scarleast/airQ-TVOC-sensor/文档/AirQ原理图.pdf

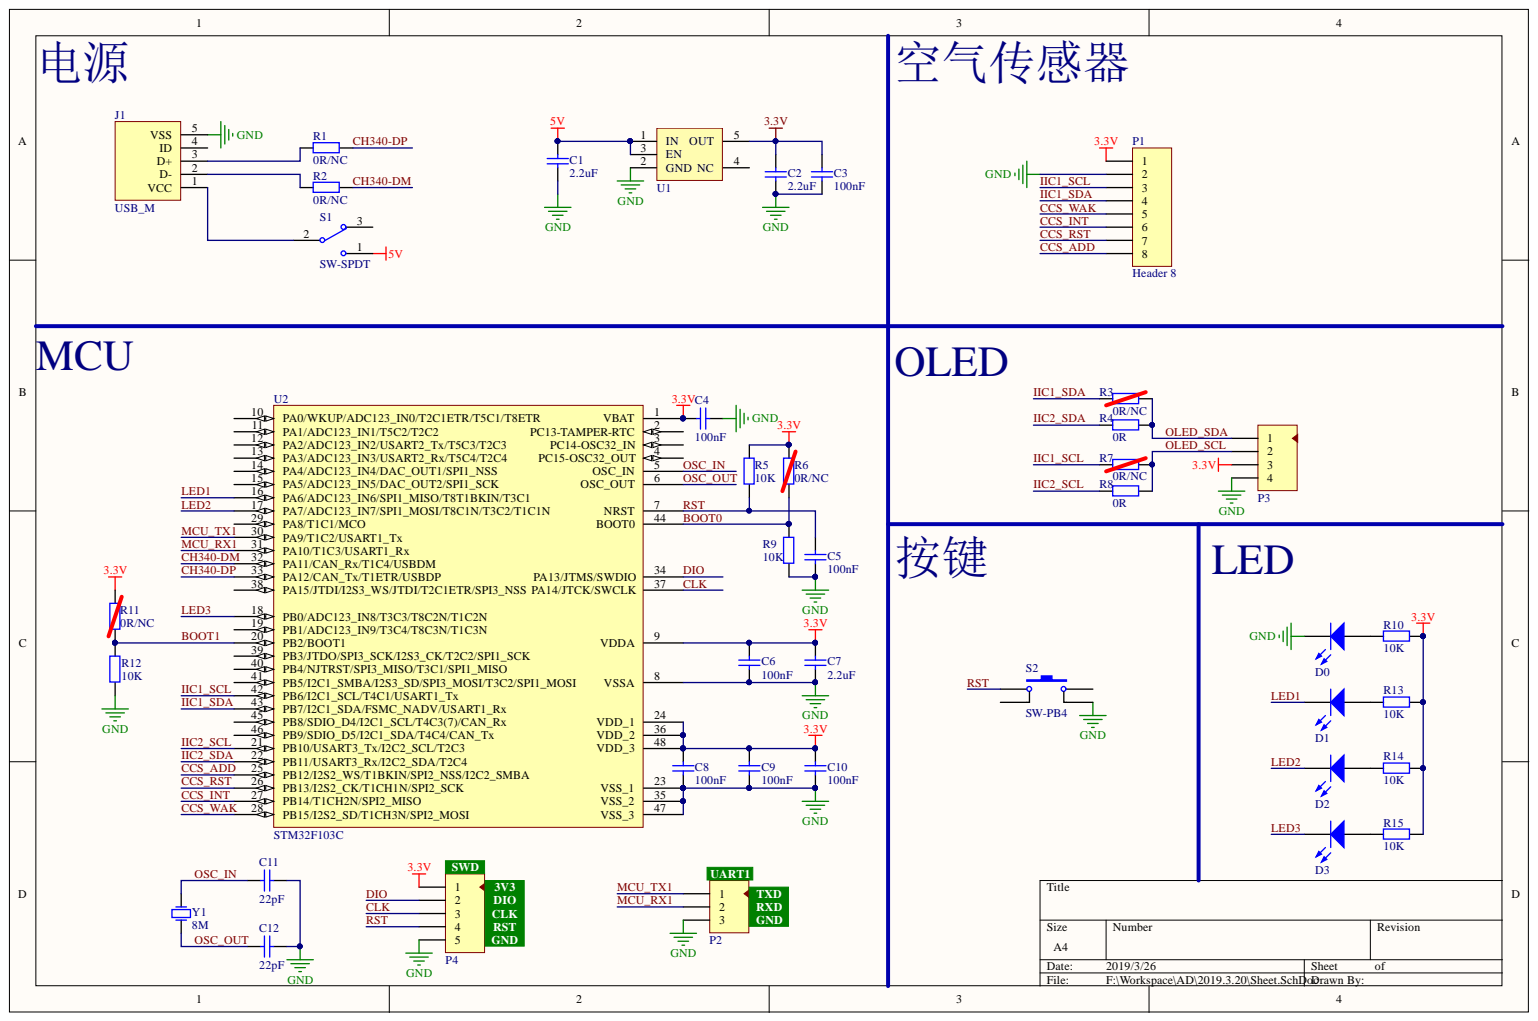
[picture p1: page 1]

Bill of Materials | Bill of Materials For Project [AirQ.PrjPCB] (No PCB Document Selected)
Source Data From: | AirQ.PrjPCB
Project: | | AirQ.PrjPCB
Variant: | | None
Creation Date: 2019/3/26 | 22:51:52
Print Date: | 26-Mar-19 | 10:52:01 PM
Footprint | Comment | LibRef | Designator | Description | Value | Quantity
C-0805 | Cap-S | Cap-S | C1, C2, C7 | 贴片瓷片电容 | 2.2uF | 3
C-0805 | Cap-S | Cap-S | C3, C4, C5, C6, C8, C9, C10 | 贴片瓷片电容 | 100nF | 7
C-0805 | Cap-S | Cap-S | C11, C12 | 贴片瓷片电容 | 22pF | 2
LED-0805 | LED0 | LED0 | D0, D1, D2, D3 | 发光二极管 | | 4

## USB-MICRO- A01SB141B1

-261 | USB_M | USB_M | J1 | Micro/Mini USB | | 1
HDR1X8 | Header 8 | Header 8 | P1 | Header, 8-Pin | | 1
HDR3X1-2.54 | Header 3 | Header 3 | P2 | 接插件 | | 1
HDR4X1-2.54 | Header 4 | Header 4 | P3 | 接插件 | | 1
HDR5X1-2.54 | Header 5 | Header 5 | P4 | 接插件 | | 1
0805-1 | Res1 | Res1 | R1, R2, R3, R6, R7, R11 | 贴片电阻 | 0R/NC | 6
0805-1 | Res1 | Res1 | R4, R8 | 贴片电阻 | 0R | 2
0805-1 | Res1 | Res1 | R5, R9, R10, R12, R13, R14, R15 | 贴片电阻 | 10K | 7
SWITCH_A2 | SW-SPDT | SW-SPDT | S1 | 开关 | | 1
SW_PB2_A1 _1 | SW-PB4 | SW-PB4 | S2 | 微动开关 | | 1
SOT23-5 | LDO-3.3V | LDO | U1 | 稳压芯片 | SPX3819 3.3V | 1
LQFP-48 | STM32F103C | STM32F103C | U2 | STM32单片机48引脚 | | 1
X-HC-49S | XTAL | XTAL | Y1 | 晶振 | 8M | 1
| | | | | | 41
Approved | | Notes
