scarleast/airQ-TVOC-sensor/(list of files, drawings)

Other design files:
硬件/AirQ.PcbDoc
硬件/AirQ.PrjPCB
硬件/AirQ.SchDoc
