scarleast/airQ-TVOC-sensor/stm32cube/Core/Src/main.c

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
/* Includes ------------------------------------------------------------------*/
#include "main.h"
#include "adc.h"
#include "i2c.h"
#include "rtc.h"
#include "usart.h"
#include "gpio.h"

/* USER CODE BEGIN Includes */
#include "oled.h"
#include "stdio.h"
#include "CCS811_Basic.h"
#include "hdc1080.h"
/* USER CODE END Includes */


void SystemClock_Config(void);
/**
  * @brief  The application entry point.
  * @retval int
  */
int main(void)
{
  /* MCU Configuration--------------------------------------------------------*/

  /* Reset of all peripherals, Initializes the Flash interface and the Systick. */
  HAL_Init();

  /* Configure the system clock */
  SystemClock_Config();

  /* Initialize all configured peripherals */
  MX_GPIO_Init();
  MX_RTC_Init();
  MX_ADC_Init();
  MX_USART1_UART_Init();
  MX_I2C2_Init();
  /* USER CODE BEGIN 2 */
	OLED_Init();
	OLED_Clear();

	OLED_ShowString(10, 0, "TVOC Sensor V2", 16);
	OLED_ShowString(40, 4, "Gaficat", 16);
	hdc1080_init();

	if(configureCCS811()){
////		  OLED_ShowString(0, 0, "ccs811 init success!", 16);
//		OLED_ShowNum(0, 4, 400, 3,16);
	}




	OLED_Clear();
//	OLED_ShowCHinese(0,2,1);
//	OLED_ShowCHinese(0,4,2);
//	OLED_ShowCHinese(0,6,3);
	OLED_ShowString(0, 0, "TVOC:", 16);
	OLED_ShowString(0, 2, "eCO2:", 16);
	OLED_ShowString(0, 4, "Temp:", 16);
	OLED_ShowString(0, 6, "humidity:", 16);

//  unsigned char data[] = "HAL UART CPU Transmit success!\t\n";
//  HAL_UART_Transmit(&huart1, data, sizeof(data), 0xffff);
//  unsigned char data1[] = "HAL UART DMA Transmit success!\t\n";
//  HAL_UART_Transmit_DMA(&huart1, data1, sizeof(data1));
//  printf("hello print! %f \n", 3.14);
//  printf("ccs init status:%d\n", configureCCS811());

//  OLED_Clear();
//  OLED_ShowChar(0, 0, 'A', 16);
//  OLED_ShowChar(0, 2, 'B', 16);
//  OLED_ShowChar(0, 4, 'C', 16);
//  OLED_ShowChar(0, 6, 'D', 16);
//
//  OLED_ShowChar(15, 0, 'A', 12);
//  OLED_ShowChar(15, 1, 'B', 12);
//  OLED_ShowChar(15, 2, 'C', 12);
//  OLED_ShowChar(15, 3, 'D', 12);
//  OLED_ShowChar(15, 4, 'E', 12);
//  OLED_ShowChar(15, 5, 'F', 12);
//  OLED_ShowChar(15, 6, 'G', 12);
//  OLED_ShowChar(15, 7, 'H', 12);
//
//  OLED_ShowString(30, 0, "mculover666", 12);
//
//  OLED_ShowCHinese(35, 2, 0);
//  OLED_ShowCHinese(65, 2, 1);
//  OLED_ShowCHinese(95, 2, 2);
//
//  OLED_ShowString(36, 6, "IoT Board", 16);



//  HAL_GPIO_WritePin(GPIOA, GPIO_PIN_0, GPIO_PIN_SET);
//  HAL_GPIO_WritePin(GPIOB, GPIO_PIN_2, GPIO_PIN_SET);
  /* USER CODE END 2 */

  /* Infinite loop */
  /* USER CODE BEGIN WHILE */

  while (1)
  {
//	  HAL_GPIO_TogglePin(GPIOB, GPIO_PIN_2);

	  HAL_Delay(1000);
    /* USER CODE END WHILE */

    /* USER CODE BEGIN 3 */
  }
  /* USER CODE END 3 */
}

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
 /**
  * @brief  Period elapsed callback in non blocking mode
  * @note   This function is called  when TIM1 interrupt took place, inside
  * HAL_TIM_IRQHandler(). It makes a direct call to HAL_IncTick() to increment
  * a global variable "uwTick" used as application time base.
  * @param  htim : TIM handle
  * @retval None
  */
void HAL_TIM_PeriodElapsedCallback(TIM_HandleTypeDef *htim)
{
  if (htim->Instance == TIM1) {
    HAL_IncTick();
  }
}

/**
  * @brief  This function is executed in case of error occurrence.
  * @retval None
  */
void Error_Handler(void)
{
  /* USER CODE BEGIN Error_Handler_Debug */
  /* User can add his own implementation to report the HAL error return state */
  __disable_irq();
  while (1)
  {
  }
  /* USER CODE END Error_Handler_Debug */
}

#ifdef  USE_FULL_ASSERT
/**
  * @brief  Reports the name of the source file and the source line number
  *         where the assert_param error has occurred.
  * @param  file: pointer to the source file name
  * @param  line: assert_param error line source number
  * @retval None
  */
void assert_failed(uint8_t *file, uint32_t line)
{
  /* USER CODE BEGIN 6 */
  /* User can add his own implementation to report the file name and line number,
     ex: printf("Wrong parameters value: file %s on line %d\r\n", file, line) */
  /* USER CODE END 6 */
}
#endif /* USE_FULL_ASSERT */

/************************ (C) COPYRIGHT STMicroelectronics *****END OF FILE****/
