scarleast/airQ-TVOC-sensor/stm32cube/Core/Inc/main.h

#define PWR_EN_Pin GPIO_PIN_0
#define PWR_EN_GPIO_Port GPIOA
#define POWER_EN_ADC_Pin GPIO_PIN_1
#define POWER_EN_ADC_GPIO_Port GPIOA
#define BAT_ADC_Pin GPIO_PIN_4
#define BAT_ADC_GPIO_Port GPIOA
#define Key1_Pin GPIO_PIN_7
#define Key1_GPIO_Port GPIOA
#define Key1_EXTI_IRQn EXTI4_15_IRQn
#define Key2_Pin GPIO_PIN_0
#define Key2_GPIO_Port GPIOB
#define Key2_EXTI_IRQn EXTI0_1_IRQn
#define Key3_Pin GPIO_PIN_1
#define Key3_GPIO_Port GPIOB
#define Key3_EXTI_IRQn EXTI0_1_IRQn
#define LED0_Pin GPIO_PIN_2
#define LED0_GPIO_Port GPIOB
#define CCS_WAKE_Pin GPIO_PIN_12
#define CCS_WAKE_GPIO_Port GPIOB
#define CCS_INT_Pin GPIO_PIN_13
#define CCS_INT_GPIO_Port GPIOB
#define CCS_INT_EXTI_IRQn EXTI4_15_IRQn
#define CCS_RST_Pin GPIO_PIN_14
#define CCS_RST_GPIO_Port GPIOB
#define CCS_ADD_Pin GPIO_PIN_15
#define CCS_ADD_GPIO_Port GPIOB
#define WB3S_KEY_Pin GPIO_PIN_8
#define WB3S_KEY_GPIO_Port GPIOA
#define WB3S_EN_Pin GPIO_PIN_11
#define WB3S_EN_GPIO_Port GPIOA
#define WB3S_CEN_Pin GPIO_PIN_12
#define WB3S_CEN_GPIO_Port GPIOA
