scarleast/airQ-TVOC-sensor/software_v1/Config/Port.c

#include "Port.h"
#include "stm32f10x.h"

/*
	配置LED的IO口
*/
static void Port_Config_LED(void)
{
	GPIO_InitTypeDef GPIO_InitStructure;
	
	RCC_APB2PeriphClockCmd(RCC_APB2Periph_GPIOA, ENABLE);   /* 开启PORTA外设时钟 */
	RCC_APB2PeriphClockCmd(RCC_APB2Periph_GPIOB, ENABLE);   /* 开启PORTB外设时钟 */
	
	RCC_APB2PeriphClockCmd(RCC_APB2Periph_AFIO, ENABLE);    /* 开启复用时钟 */
	GPIO_PinRemapConfig(GPIO_Remap_SWJ_JTAGDisable, ENABLE);/* 禁用PB4的JTAG复用 */
	
	GPIO_InitStructure.GPIO_Pin = GPIO_Pin_6 | GPIO_Pin_7;
	GPIO_InitStructure.GPIO_Mode = GPIO_Mode_Out_PP;
	GPIO_InitStructure.GPIO_Speed = GPIO_Speed_50MHz;
	
	GPIO_Init(GPIOA, &GPIO_InitStructure);
    
    GPIO_InitStructure.GPIO_Pin = GPIO_Pin_0;
    GPIO_Init(GPIOB, &GPIO_InitStructure);
}

/*
	CCS相关GPIO配置
*/
static void Port_Config_CCS(void)
{
	GPIO_InitTypeDef GPIO_InitStructure;
    
	RCC_APB2PeriphClockCmd(RCC_APB2Periph_GPIOB, ENABLE);/* 开启PORTb外设时钟 */
	
	/* PB.12,13,15上拉输出 */
	GPIO_InitStructure.GPIO_Pin = GPIO_Pin_12 | GPIO_Pin_13 | GPIO_Pin_15;
	GPIO_InitStructure.GPIO_Mode = GPIO_Mode_Out_PP;
	GPIO_Init(GPIOB, &GPIO_InitStructure);
    
	/* PB.14上拉输入 */
	GPIO_InitStructure.GPIO_Pin = GPIO_Pin_14;
	GPIO_InitStructure.GPIO_Mode = GPIO_Mode_IPU;
	GPIO_Init(GPIOB, &GPIO_InitStructure);
    
    GPIO_SetBits(GPIOB, GPIO_Pin_12 | GPIO_Pin_13 | GPIO_Pin_15);
}

/*
	IIC2相关GPIO配置
*/
static void Port_Config_IIC2(void)
{
	GPIO_InitTypeDef GPIO_InitStructure;
    
	RCC_APB2PeriphClockCmd(RCC_APB2Periph_GPIOB, ENABLE);/* 开启PORTb外设时钟 */
	
	/* PB.10, PB.11上拉输入 */
	GPIO_InitStructure.GPIO_Pin = GPIO_Pin_10 | GPIO_Pin_11;
	GPIO_InitStructure.GPIO_Mode = GPIO_Mode_Out_PP;
	GPIO_Init(GPIOB, &GPIO_InitStructure);
    
    GPIO_SetBits(GPIOB, GPIO_Pin_10 | GPIO_Pin_11);
}

/*
	UART2相关GPIO配置
*/
static void Port_Config_UART2(void)
{
	GPIO_InitTypeDef GPIO_InitStructure;
    
	RCC_APB2PeriphClockCmd(RCC_APB2Periph_GPIOA, ENABLE);/* 开启PORTb外设时钟 */
	
	/* UART2 Tx (PA.9) 复用上拉输出 */
	GPIO_InitStructure.GPIO_Pin = GPIO_Pin_9;
	GPIO_InitStructure.GPIO_Mode = GPIO_Mode_AF_PP;
	GPIO_InitStructure.GPIO_Speed = GPIO_Speed_50MHz;
	GPIO_Init(GPIOA, &GPIO_InitStructure);
    
    /* UART2 Rx (PA.10) 浮空输入 */
	GPIO_InitStructure.GPIO_Pin = GPIO_Pin_10;
	GPIO_InitStructure.GPIO_Mode = GPIO_Mode_IPU;
	GPIO_Init(GPIOA, &GPIO_InitStructure);
}

static void Port_Config_IIC1(void)
{
	GPIO_InitTypeDef GPIO_InitStructure;
	
	/* 使能与 I2C有关的时钟 */
	RCC_APB2PeriphClockCmd(RCC_APB2Periph_GPIOB, ENABLE );  

	/* PB6-I2C_SCL、PB7-I2C_SDA*/
	GPIO_InitStructure.GPIO_Pin = GPIO_Pin_6 | GPIO_Pin_7; 
	GPIO_InitStructure.GPIO_Speed = GPIO_Speed_10MHz; 
	GPIO_InitStructure.GPIO_Mode = GPIO_Mode_Out_OD; 
    
	GPIO_Init(GPIOB, &GPIO_InitStructure); 
	GPIO_SetBits(GPIOB, GPIO_Pin_6 | GPIO_Pin_7);
}

void Port_Init(void)
{
    Port_Config_LED();
    Port_Config_CCS();
    Port_Config_IIC2();
    Port_Config_UART2();
    Port_Config_IIC1();
}
