scarleast/airQ-TVOC-sensor/software_v1/USER/exti.c

#include "exti.h"

/*
	外部中断配置函数
*/
void NVIC_Config(uint8_t state)
{
	NVIC_InitTypeDef NVIC_InitStructure;
	
	NVIC_PriorityGroupConfig(NVIC_PriorityGroup_2);
	
	NVIC_InitStructure.NVIC_IRQChannel = EXTI0_IRQn;
	NVIC_InitStructure.NVIC_IRQChannelPreemptionPriority = 1;
	NVIC_InitStructure.NVIC_IRQChannelSubPriority = 0;
	
	if(state == 1)
	{
		NVIC_InitStructure.NVIC_IRQChannelCmd = ENABLE;
	}
	else
	{
		NVIC_InitStructure.NVIC_IRQChannelCmd = DISABLE;
	}
	NVIC_Init(&NVIC_InitStructure);
    NVIC_InitStructure.NVIC_IRQChannel = EXTI9_5_IRQn;
	NVIC_Init(&NVIC_InitStructure);
}

/*
	GPIO与外部中断的配置
*/
void EXTI_PA11_PA12_Config(uint8_t state)
{
//	GPIO_InitTypeDef GPIO_InitStructure;
	EXTI_InitTypeDef EXTI_InitStructure;
	
	RCC_APB2PeriphClockCmd(RCC_APB2Periph_GPIOA | RCC_APB2Periph_AFIO,ENABLE);
	
	NVIC_Config(state);
	
//	GPIO_InitStructure.GPIO_Pin = GPIO_Pin_0 | GPIO_Pin_8;
//	GPIO_InitStructure.GPIO_Mode = GPIO_Mode_IPU;
//	GPIO_Init(GPIOC,&GPIO_InitStructure);
	
	GPIO_EXTILineConfig(GPIO_PortSourceGPIOA, GPIO_PinSource0 | GPIO_PinSource8);
	EXTI_InitStructure.EXTI_Line = EXTI_Line0 | EXTI_Line8;
	EXTI_InitStructure.EXTI_Mode = EXTI_Mode_Interrupt;
	EXTI_InitStructure.EXTI_Trigger = EXTI_Trigger_Rising_Falling;
	EXTI_InitStructure.EXTI_LineCmd = ENABLE;
	EXTI_Init(&EXTI_InitStructure);
}
