scarleast/airQ-TVOC-sensor/software_v1/USER/usart.c

#include "usart.h"

void USART_NVIC_Configuration(void)
{
	NVIC_InitTypeDef NVIC_InitStructure; 
	/* Configure the NVIC Preemption Priority Bits */  
	NVIC_PriorityGroupConfig(NVIC_PriorityGroup_2);
	
	/* Enable the USARTy Interrupt */
	NVIC_InitStructure.NVIC_IRQChannel = USART1_IRQn;	 
	NVIC_InitStructure.NVIC_IRQChannelPreemptionPriority = 1;
	NVIC_InitStructure.NVIC_IRQChannelSubPriority = 0;
	NVIC_InitStructure.NVIC_IRQChannelCmd = ENABLE;
	NVIC_Init(&NVIC_InitStructure);
	
	NVIC_InitStructure.NVIC_IRQChannel = USART2_IRQn;
	NVIC_Init(&NVIC_InitStructure);
}

/*
 * 函数名：USART1_Config
 * 描述  ：USART1 GPIO 配置,工作模式配置
 * 输入  ：无
 * 输出  : 无
 * 调用  ：外部调用
 */
void USART1_Config(void)
{
	USART_InitTypeDef USART_InitStructure;
	
	/* config USART3 clock */
	RCC_APB2PeriphClockCmd(RCC_APB2Periph_USART1, ENABLE);
	RCC_APB2PeriphClockCmd(RCC_APB2Periph_GPIOB, ENABLE);
	
	/* USART3 mode config */
	USART_InitStructure.USART_BaudRate = 115200;
	USART_InitStructure.USART_WordLength = USART_WordLength_8b;
	USART_InitStructure.USART_StopBits = USART_StopBits_1;
	USART_InitStructure.USART_Parity = USART_Parity_No ;
	USART_InitStructure.USART_HardwareFlowControl = USART_HardwareFlowControl_None;
	USART_InitStructure.USART_Mode = USART_Mode_Rx | USART_Mode_Tx;
	USART_Init(USART1, &USART_InitStructure);
	USART_ITConfig(USART1, USART_IT_RXNE, ENABLE);
	
	USART_Cmd(USART1, ENABLE);
	
	USART_NVIC_Configuration();
}

/*
 * 函数名：USART2_Config
 * 描述  ：USART1 GPIO 配置,工作模式配置
 * 输入  ：无
 * 输出  : 无
 * 调用  ：外部调用
 */
void USART2_Config(void)
{
	USART_InitTypeDef USART_InitStructure;
	
	/* config USART2 clock */
	RCC_APB1PeriphClockCmd(RCC_APB1Periph_USART2, ENABLE);
	
	/* USART3 mode config */
	USART_InitStructure.USART_BaudRate = 9600;
	USART_InitStructure.USART_WordLength = USART_WordLength_8b;
	USART_InitStructure.USART_StopBits = USART_StopBits_1;
	USART_InitStructure.USART_Parity = USART_Parity_No ;
	USART_InitStructure.USART_HardwareFlowControl = USART_HardwareFlowControl_None;
	USART_InitStructure.USART_Mode = USART_Mode_Rx | USART_Mode_Tx;
	USART_Init(USART2, &USART_InitStructure);
	USART_ITConfig(USART2, USART_IT_RXNE, ENABLE);
	
	USART_Cmd(USART2, ENABLE);
	
	USART_NVIC_Configuration();
}

void uart_write(char * string)
{
    while(*string != '\0')
    {
        USART_SendData(USART1, (unsigned char) *string++);
        while (!(USART1->SR & USART_FLAG_TXE));
    }
}

/*
 * 函数名：fputc
 * 描述  ：重定向c库函数printf到USART1
 * 输入  ：无
 * 输出  ：无
 * 调用  ：由printf调用
 */
int fputc(int ch, FILE *f)
{
	/* 将Printf内容发往串口 */
	USART_SendData(USART1, (unsigned char) ch);
	while (!(USART1->SR & USART_FLAG_TXE));
	
	return (ch);
}

/******************* (C) COPYRIGHT 2012 WildFire Team *****END OF FILE************/
