scarleast/airQ-TVOC-sensor/(commit log)

2019-08-03 fist commit
    [AirQ.PcbDoc, AirQ.PrjPCB, AirQ.SchDoc]
2019-08-03 添加了一些内容
2021-11-01 upload version by stm32cube
2021-11-01 upload stm32cube version
