scarleast/airQ-TVOC-sensor/(notices)

Notices in the files:
software_v1/HARDWARE/OLED/oled.h:
Copyright(C) ÖÐ¾°Ô°µç×Ó2014/3/16
All rights reserved
